enkhbold470/probelab/media/bottom.png

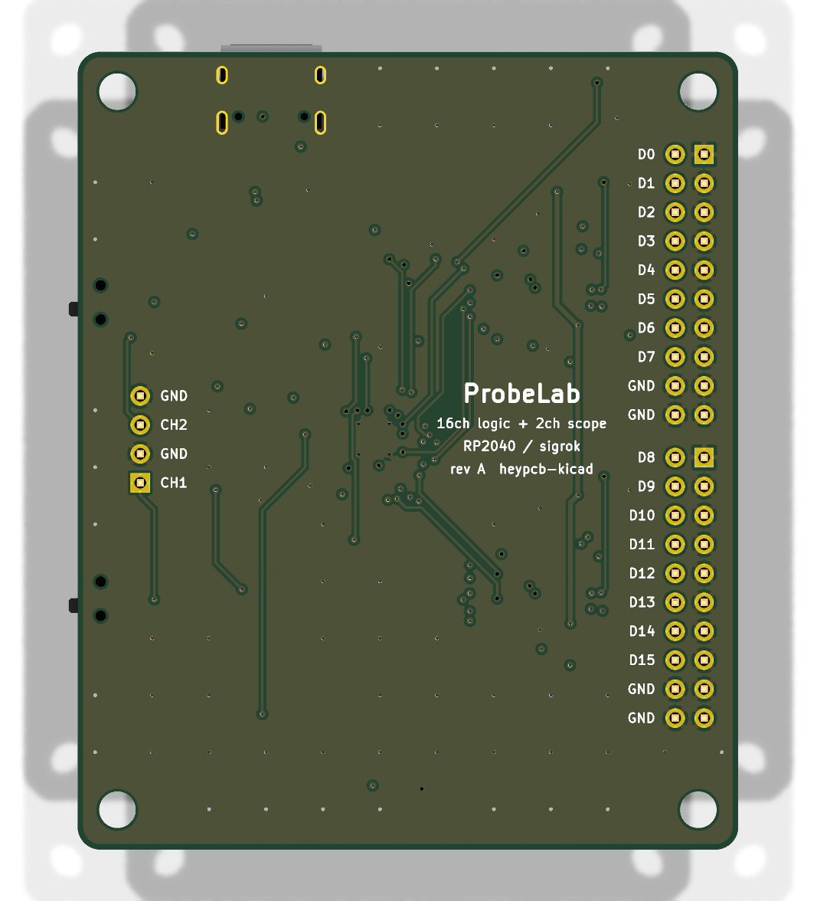
media/bottom.png
