enkhbold470/probelab/media/top.png

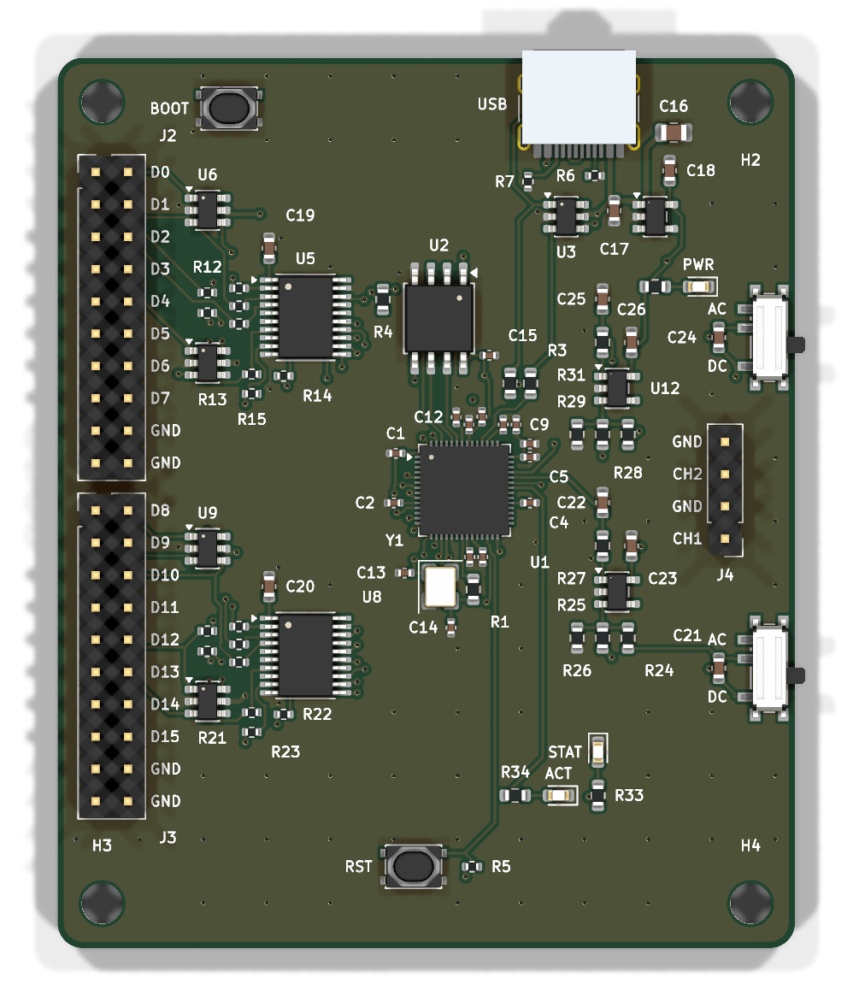
media/top.png
