enkhbold470/probelab/fab/probelab_bom.csv

Reference | Value | Footprint | MPN | LCSC | Qty
C1,C2,C3,C4,C5,C6,C7,C8,C11,C12,C15 | 100nF | Capacitor_SMD:C_0402_1005Metric | CL05B104KO5NNNC | C1525 | 11
C9,C10 | 1uF | Capacitor_SMD:C_0402_1005Metric | CL05A105KA5NQNC | C52923 | 2
C13,C14 | 15pF | Capacitor_SMD:C_0402_1005Metric | 0402CG150J500NT | C1548 | 2
C16 | 10uF | Capacitor_SMD:C_0805_2012Metric | CL21A106KAYNNNE | C15850 | 1
C17,C18 | 1uF | Capacitor_SMD:C_0603_1608Metric | CL10A105KB8NNNC | C15849 | 2
C19,C20,C21,C23,C24,C26 | 100nF | Capacitor_SMD:C_0603_1608Metric | CC0603KRX7R9BB104 | C14663 | 6
C22,C25 | 1nF | Capacitor_SMD:C_0603_1608Metric | CL10B102KB8NNNC | C1588 | 2
D1 | Green (PWR) | LED_SMD:LED_0603_1608Metric | KT-0603G | C12624 | 1
D2 | Red (STAT) | LED_SMD:LED_0603_1608Metric | KT-0603R | C2286 | 1
D3 | Red (ACT) | LED_SMD:LED_0603_1608Metric | KT-0603R | C2286 | 1
J1 | USB-C | Connector_USB:USB_C_Receptacle_HRO_TYPE-C-31-M-12 | TYPE-C-31-M-12 | C165948 | 1
J2,J3 | Conn_02x10 | Connector_PinHeader_2.54mm:PinHeader_2x10_P2.54mm_Vertical | PZ254V-12-20P | C492427 | 2
J4 | SCOPE | Connector_PinHeader_2.54mm:PinHeader_1x04_P2.54mm_Vertical | PZ254V-11-04P | C2691448 | 1
R1,R4,R32,R33,R34 | 1k | Resistor_SMD:R_0603_1608Metric | 0603WAF1001T5E | C21190 | 5
R2,R3 | 27R | Resistor_SMD:R_0603_1608Metric | 0603WAF270JT5E | C25190 | 2
R5 | 10k | Resistor_SMD:R_0402_1005Metric | 0402WGF1002TCE | C25744 | 1
R6,R7 | 5.1k | Resistor_SMD:R_0402_1005Metric | 0402WGF5101TCE | C25905 | 2
R8,R9,R10,R11,R12,R13,R14,R15,R16,R17,R18,R19,R20,R21,R22,R23 | 100R | Resistor_SMD:R_0402_1005Metric | 0402WGF1000TCE | C25076 | 16
R24,R28 | 1M | Resistor_SMD:R_0603_1608Metric | 0603WAF1004T5E | C22935 | 2
R25,R26,R29,R30 | 220k | Resistor_SMD:R_0603_1608Metric | 0603WAF2203T5E | C22961 | 4
R27,R31 | 47R | Resistor_SMD:R_0603_1608Metric | 0603WAF470JT5E | C23182 | 2
SW1,SW2 | PCM12SMTR | Button_Switch_SMD:SW_SPDT_PCM12 | PCM12SMTR | C221841 | 2
SW3 | BOOTSEL | Button_Switch_SMD:SW_SPST_PTS810 | PTS810SJM250SMTRLFS | C116501 | 1
SW4 | RESET | Button_Switch_SMD:SW_SPST_PTS810 | PTS810SJM250SMTRLFS | C116501 | 1
U1 | RP2040 | Package_DFN_QFN:QFN-56-1EP_7x7mm_P0.4mm_EP3.2x3.2mm_ThermalVias | RP2040 | C2040 | 1
U2 | W25Q128JVSIQ | Package_SO:SOIC-8_5.3x5.3mm_P1.27mm | W25Q128JVSIQ | C97521 | 1
U3 | USBLC6-2SC6 | Package_TO_SOT_SMD:SOT-23-6 | USBLC6-2SC6 | C7519 | 1
U4 | AP2112K-3.3 | Package_TO_SOT_SMD:SOT-23-5 | AP2112K-3.3TRG1 | C51118 | 1
U5,U8 | SN74LVC245APWR | Package_SO:TSSOP-20_4.4x6.5mm_P0.65mm | SN74LVC245APWR | C7848 | 2
U6,U7,U9,U10 | USBLC6-4SC6 | Package_TO_SOT_SMD:SOT-23-6 | USBLC6-4SC6 | C111212 | 4
U11,U12 | TLV9061IDBVR | Package_TO_SOT_SMD:SOT-23-5 | TLV9061IDBVR | C398358 | 2
Y1 | 12MHz | Crystal:Crystal_SMD_3225-4Pin_3.2x2.5mm | ABM8-272-T3 | C20625731 | 1
