enkhbold470/probelab/fab/probelab.step

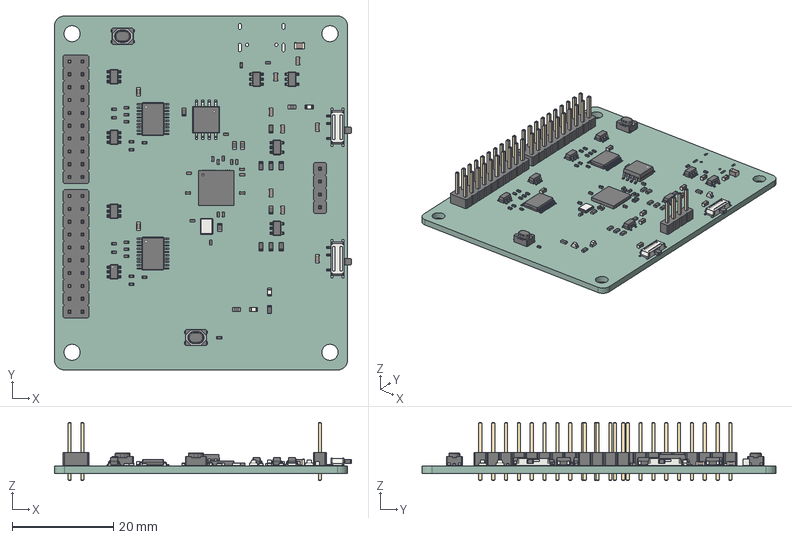
[picture p5: CAD file, 2026-10-02]
fab/probelab.step
58.8 x 70.0 x 11.5 mm
C_0402_1005Metric x 15
C_0603_1608Metric x 10
R_0402_1005Metric x 19
R_0603_1608Metric x 15
SOT-23-6 x 5
PinHeader_2x10_P254mm_Vertical x 2
PinHeader_1x04_P254mm_Vertical
SOT-23-5 x 3
SOIC-8_5.3x5.3mm_P1.27mm
Fusion_sp x 2
TSSOP-20_4.4x6.5mm_P0.65mm x 2
Crystal_SMD_3225-4Pin_3.2x2.5mm
QFN-56-1EP_7x7mm_P0.4mm_EP3.2x3.2mm
SW_SPST_PTS810 x 2
LED_0603_1608Metric x 3
C_0805_2012Metric
probelab_PCB
