enkhbold470/probelab/fab/probelab_schematic.pdf

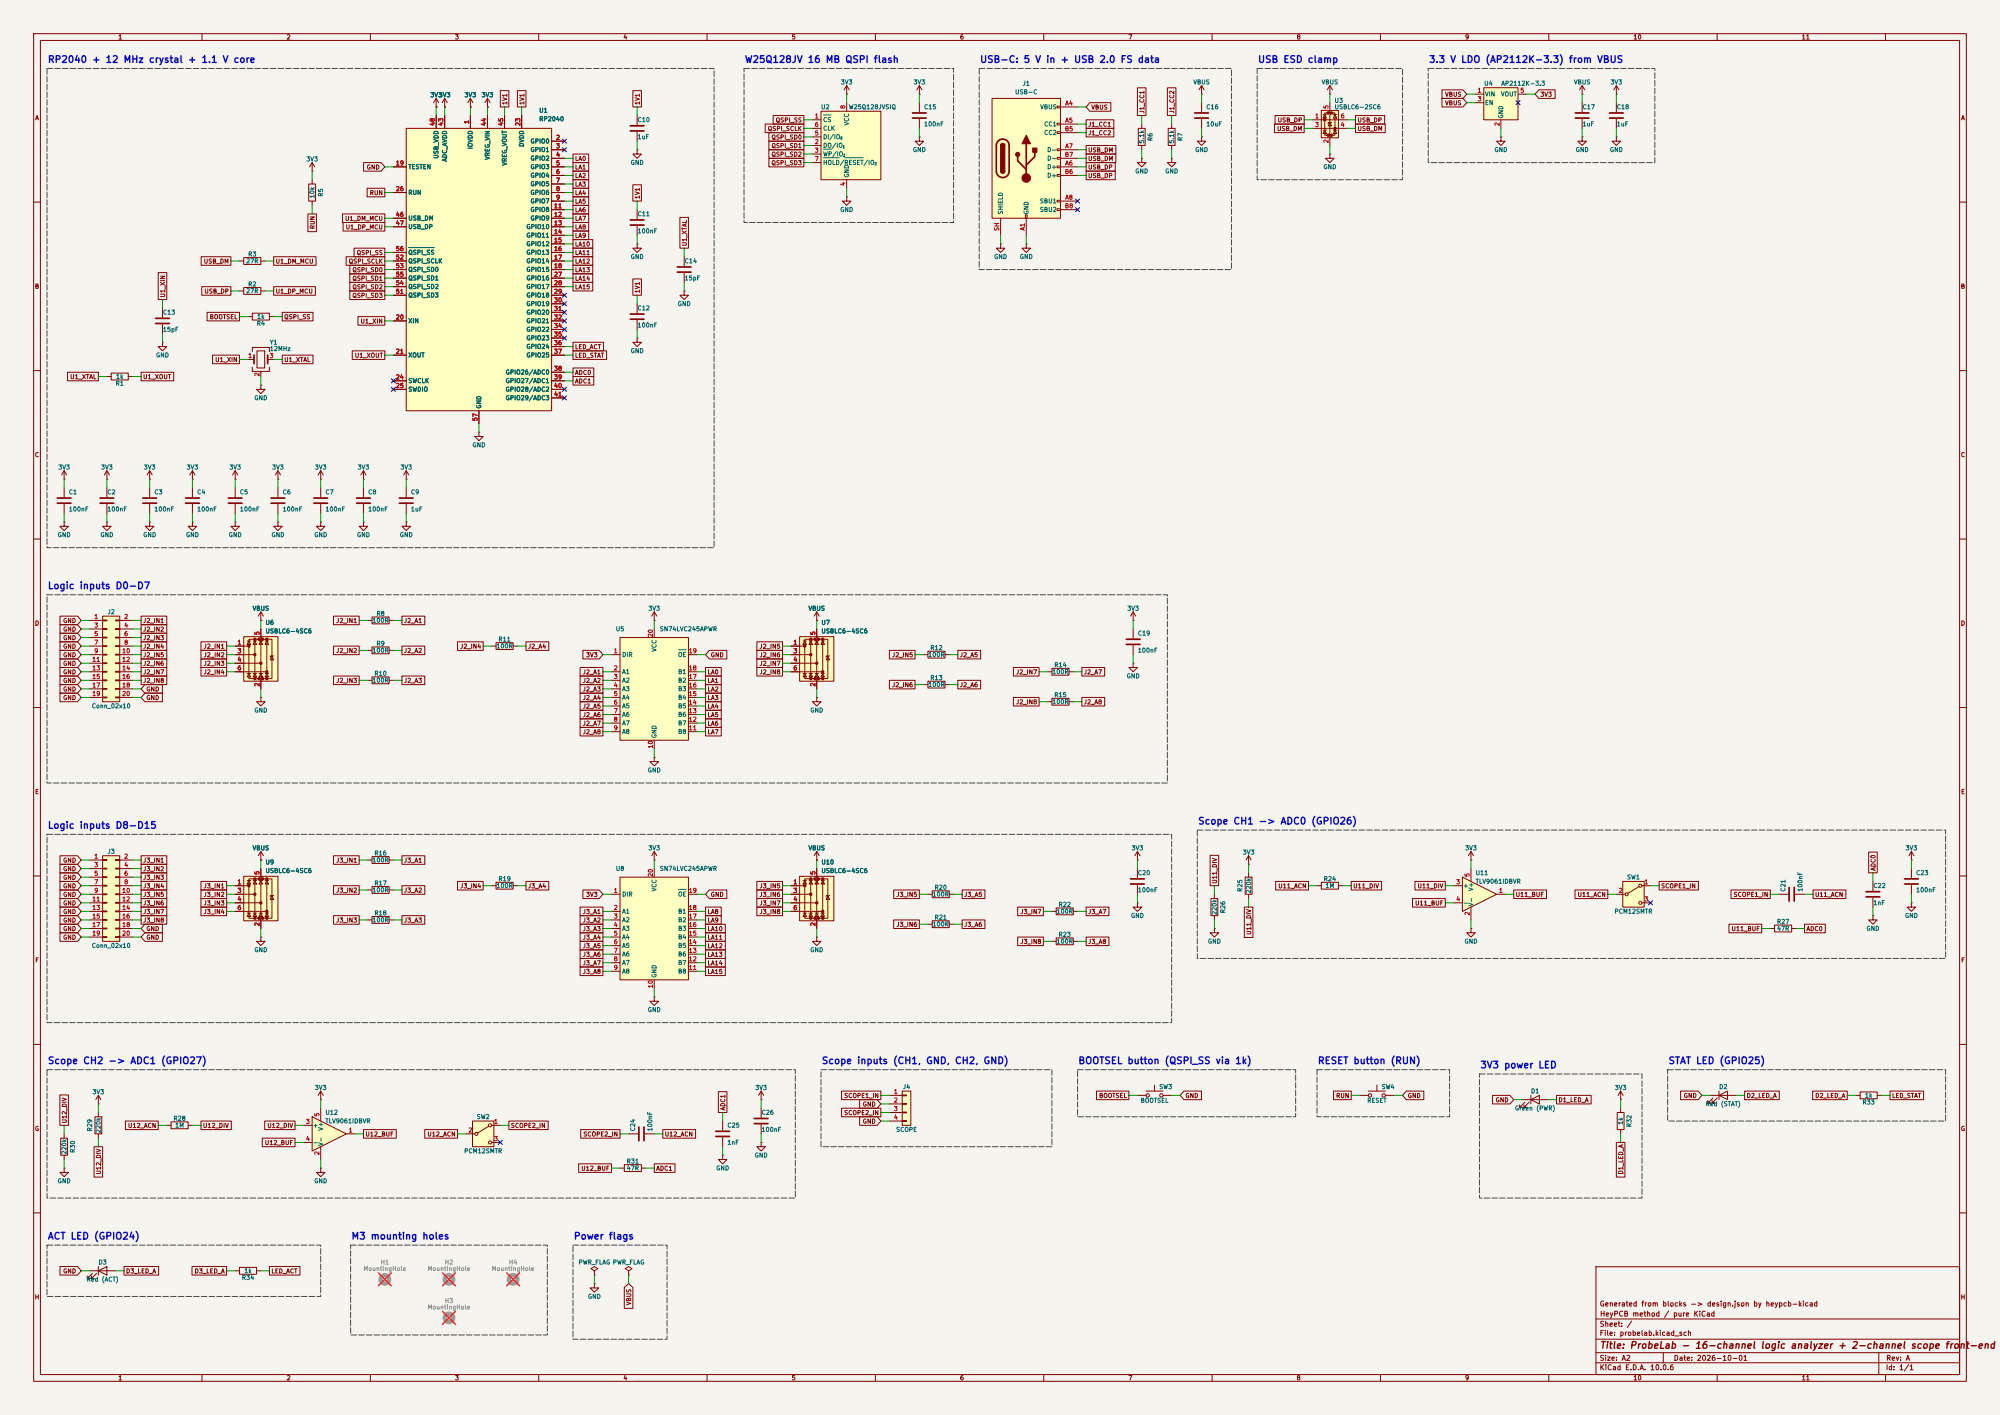
[picture p6: page 1]

4 DI/IO0 5 CLK 6 HOLD/RESET/IO3 7 VCC U2 8W25Q128JVSIQ

Scope inputs (CH1, GND, CH2, GND)

Generated from blocks -> design.json by heypcb-kicad
HeyPCB method / pure KiCad
Sheet: /
File: probelab.kicad_sch
Title: ProbeLab - 16-channel logic analyzer + 2-channel scope front-end (RP2040)

Size: A2 | Rev: A
KiCad E.D.A. 10.0.6 | Id: 1/1
