enkhbold470/probelab/kicad/probelab.kicad_pcb

## KiCad design kicad/probelab.kicad_pcb (2026-10-02)

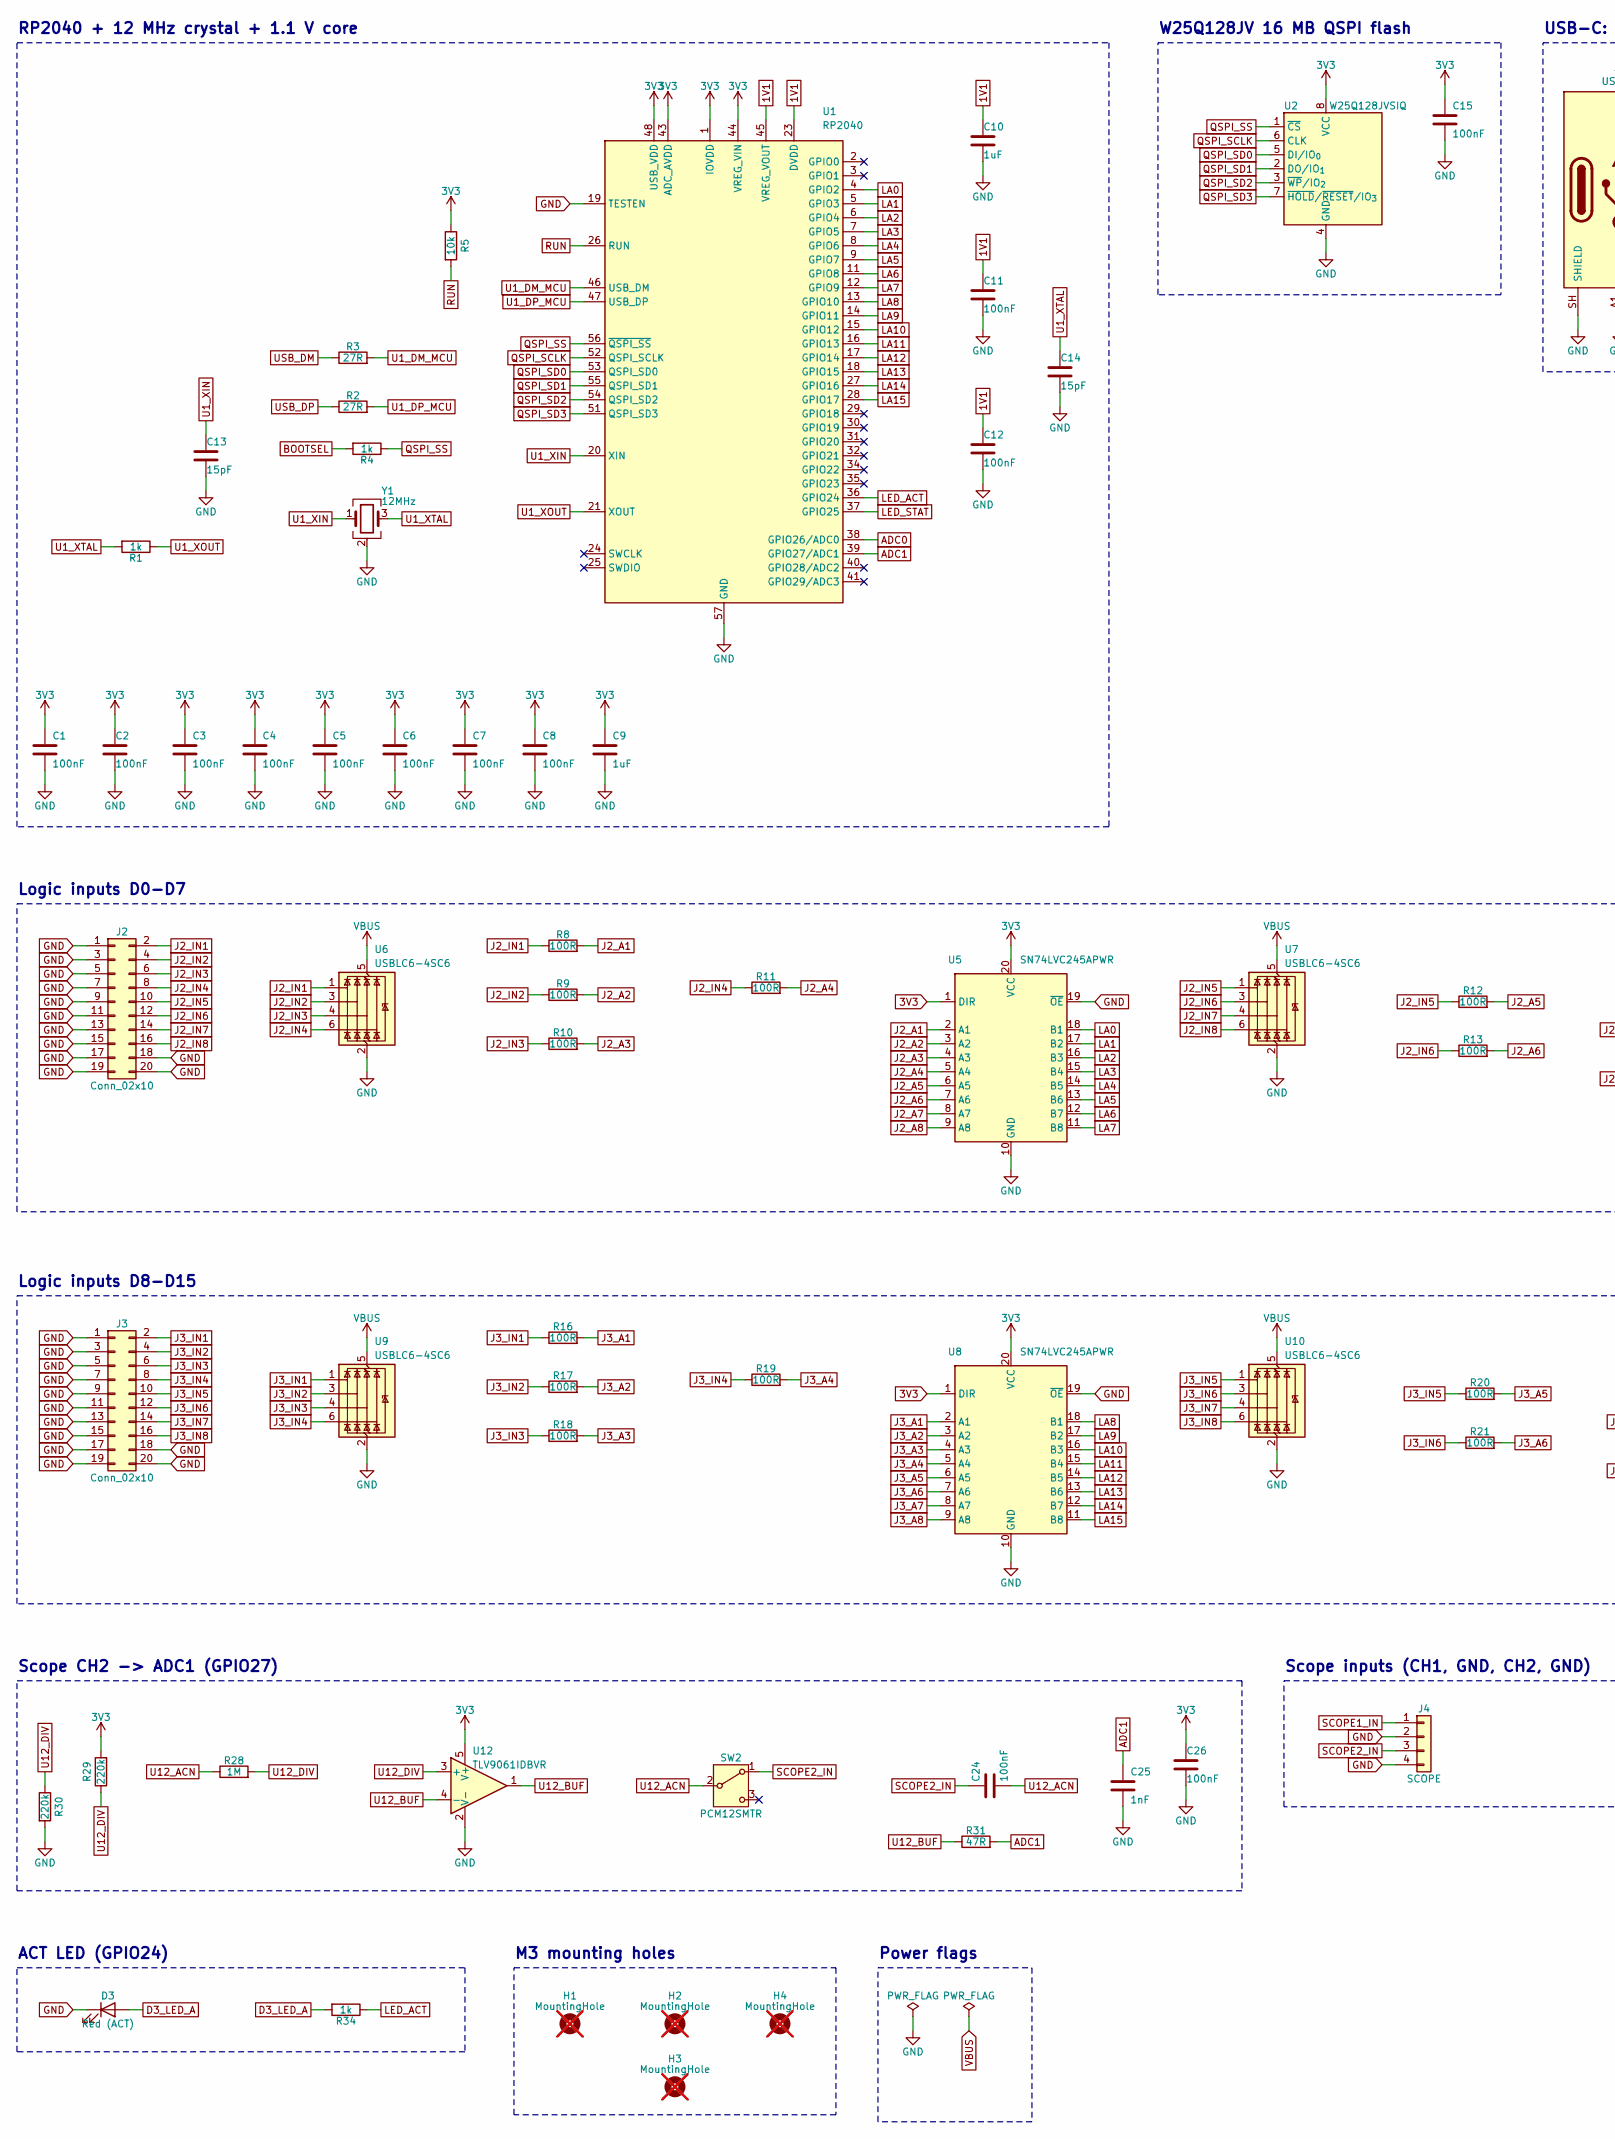
[picture p7: schematic probelab.kicad_sch, ProbeLab - 16-channel logic analyzer + 2-channel scope fron…, part in row 1, column 1]

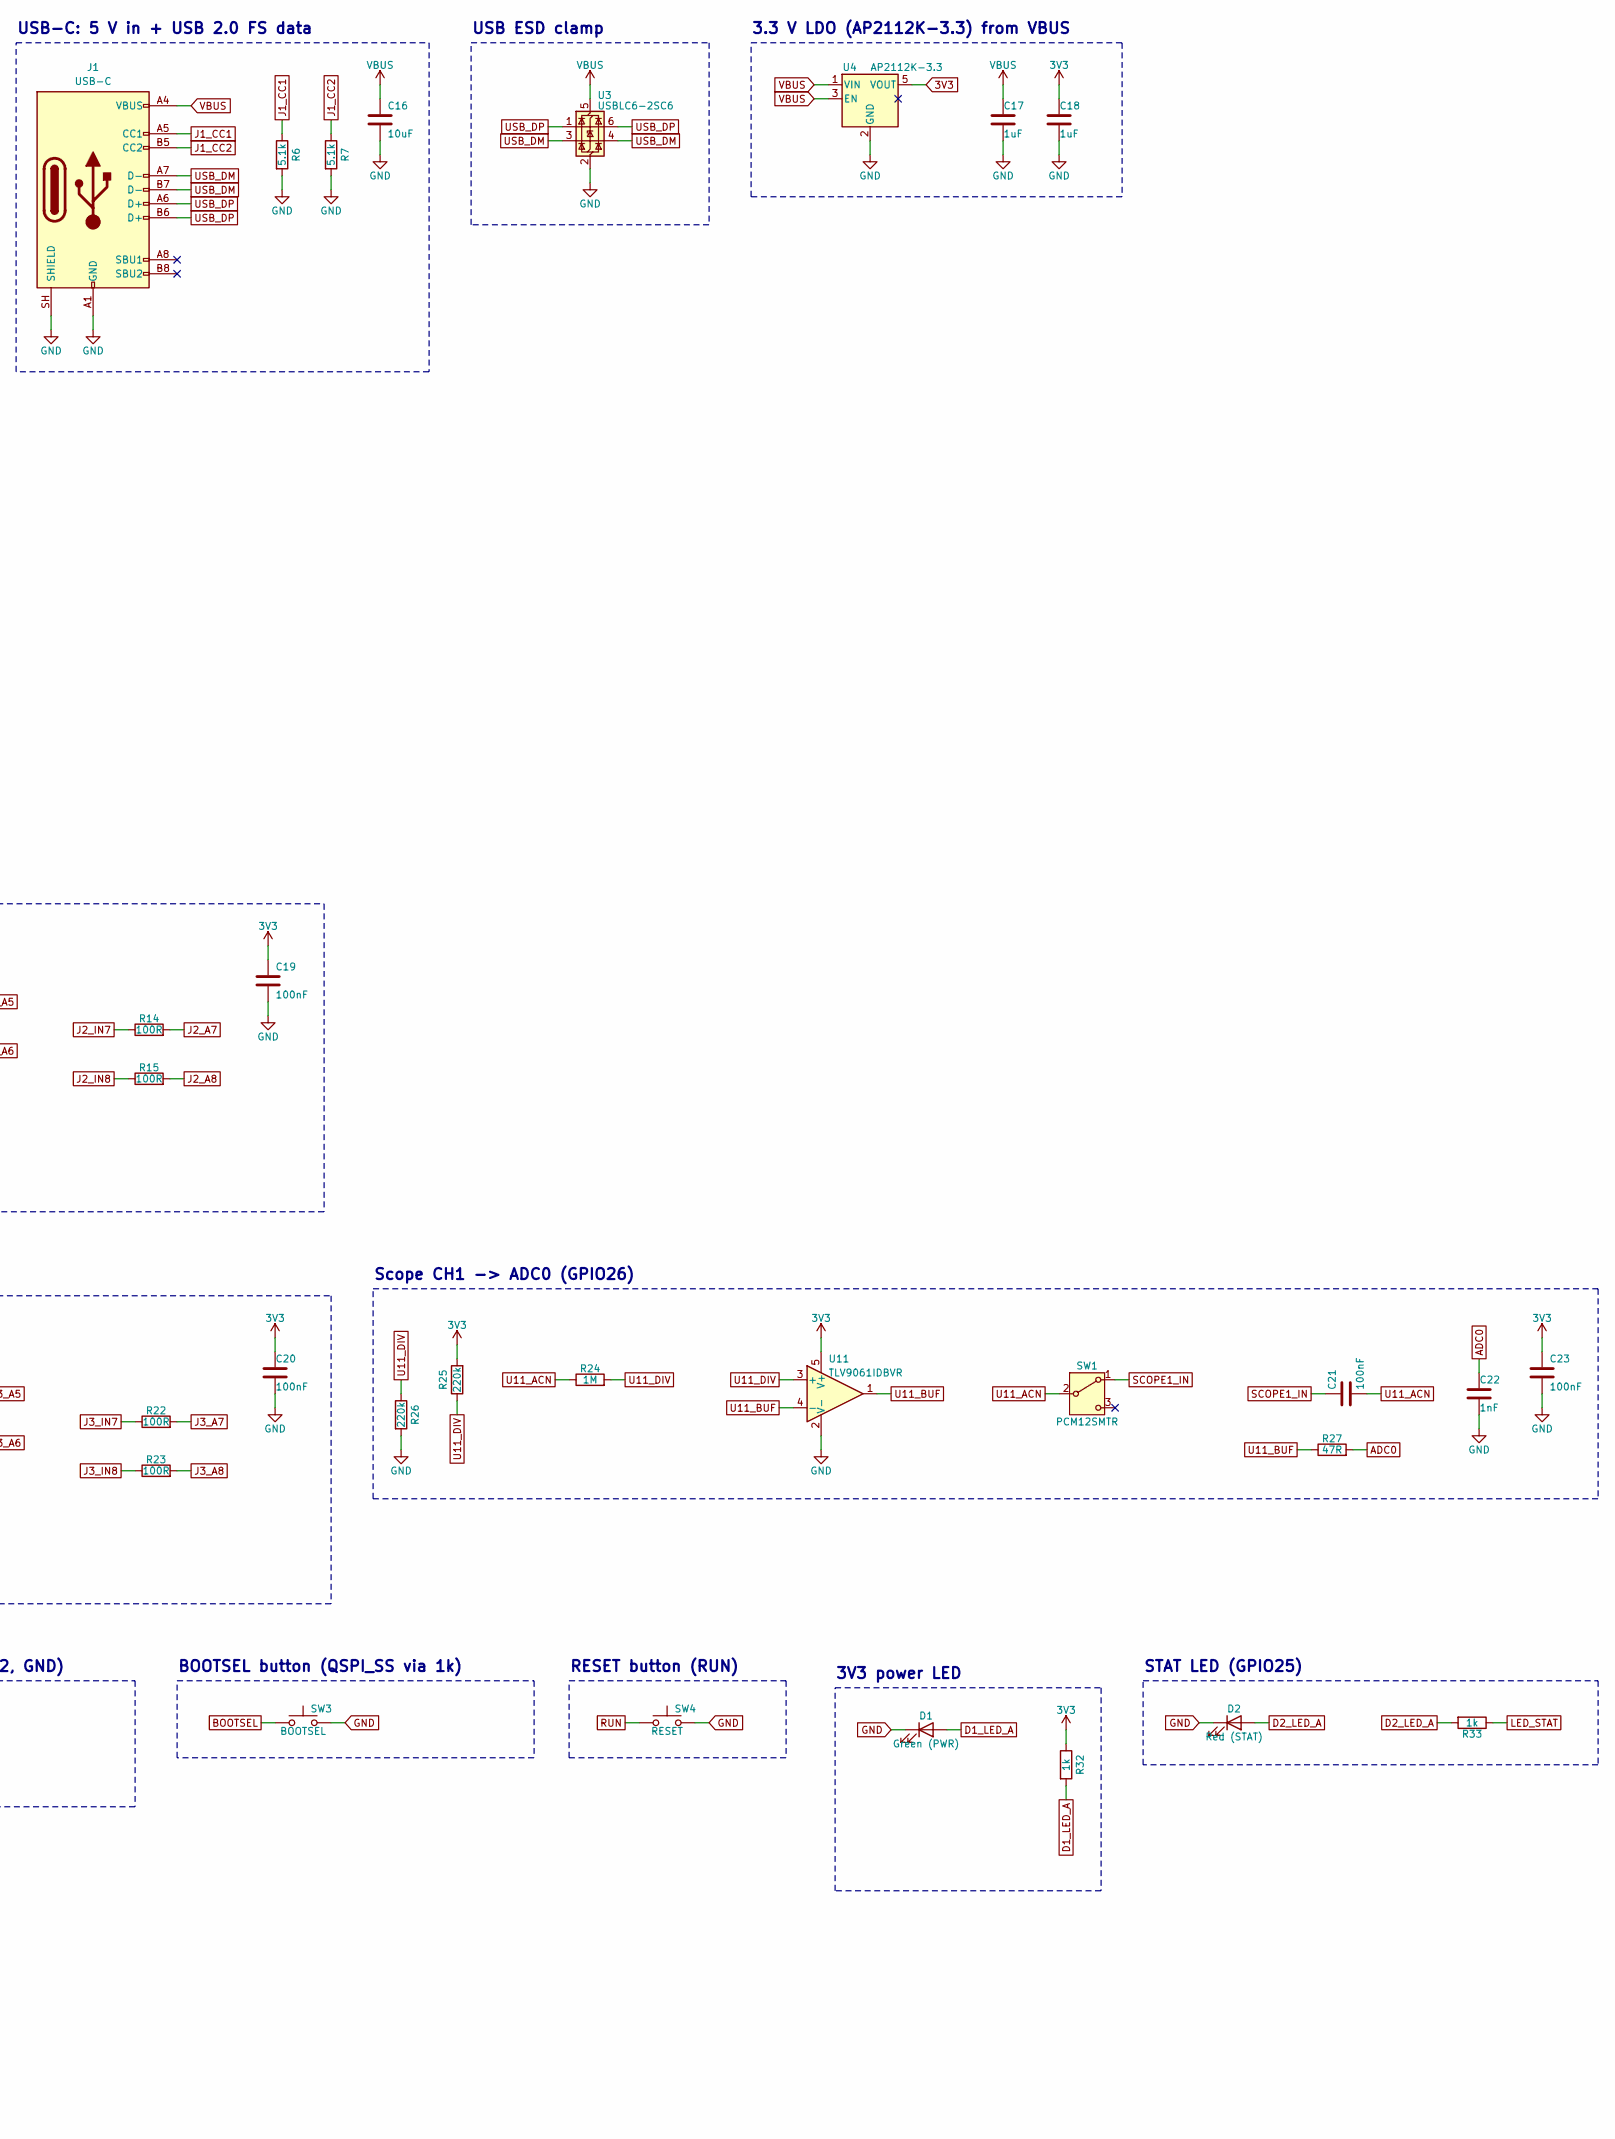
[picture p8: schematic probelab.kicad_sch, ProbeLab - 16-channel logic analyzer + 2-channel scope fron…, part in row 1, column 2]

Parts:
C1, C2, C3, C4, C5, C6, C7, C8, C11, C12, C15: 100nF; C_0402_1005Metric; MPN CL05B104KO5NNNC; LCSC C1525
C9, C10: 1uF; C_0402_1005Metric; MPN CL05A105KA5NQNC; LCSC C52923
C13, C14: 15pF; C_0402_1005Metric; MPN 0402CG150J500NT; LCSC C1548
C16: 10uF; C_0805_2012Metric; MPN CL21A106KAYNNNE; LCSC C15850
C17, C18: 1uF; C_0603_1608Metric; MPN CL10A105KB8NNNC; LCSC C15849
C19, C20, C21, C23, C24, C26: 100nF; C_0603_1608Metric; MPN CC0603KRX7R9BB104; LCSC C14663
C22, C25: 1nF; C_0603_1608Metric; MPN CL10B102KB8NNNC; LCSC C1588
D1: Green (PWR); LED_0603_1608Metric; MPN KT-0603G; LCSC C12624
D2: Red (STAT); LED_0603_1608Metric; MPN KT-0603R; LCSC C2286
D3: Red (ACT); LED_0603_1608Metric; MPN KT-0603R; LCSC C2286
H1, H2, H3, H4: MountingHole; MountingHole_3.2mm_M3; not fitted
J1: USB-C; USB_C_Receptacle_HRO_TYPE-C-31-M-12; MPN TYPE-C-31-M-12; LCSC C165948
J2, J3: Conn_02x10; PinHeader_2x10_P2.54mm_Vertical; MPN PZ254V-12-20P; LCSC C492427
J4: SCOPE; PinHeader_1x04_P2.54mm_Vertical; MPN PZ254V-11-04P; LCSC C2691448
R1, R4, R32, R33, R34: 1k; R_0603_1608Metric; MPN 0603WAF1001T5E; LCSC C21190
R2, R3: 27R; R_0603_1608Metric; MPN 0603WAF270JT5E; LCSC C25190
R5: 10k; R_0402_1005Metric; MPN 0402WGF1002TCE; LCSC C25744
R6, R7: 5.1k; R_0402_1005Metric; MPN 0402WGF5101TCE; LCSC C25905
R8, R9, R10, R11, R12, R13, R14, R15, R16, R17, R18, R19, R20, R21, R22, R23: 100R; R_0402_1005Metric; MPN 0402WGF1000TCE; LCSC C25076
R24, R28: 1M; R_0603_1608Metric; MPN 0603WAF1004T5E; LCSC C22935
R25, R26, R29, R30: 220k; R_0603_1608Metric; MPN 0603WAF2203T5E; LCSC C22961
R27, R31: 47R; R_0603_1608Metric; MPN 0603WAF470JT5E; LCSC C23182
SW1, SW2: PCM12SMTR; SW_SPDT_PCM12; MPN PCM12SMTR; LCSC C221841
SW3: BOOTSEL; SW_SPST_PTS810; MPN PTS810SJM250SMTRLFS; LCSC C116501
SW4: RESET; SW_SPST_PTS810; MPN PTS810SJM250SMTRLFS; LCSC C116501
U1: RP2040; QFN-56-1EP_7x7mm_P0.4mm_EP3.2x3.2mm_ThermalVias; MPN RP2040; LCSC C2040
U2: W25Q128JVSIQ; SOIC-8_5.3x5.3mm_P1.27mm; MPN W25Q128JVSIQ; LCSC C97521
U3: USBLC6-2SC6; SOT-23-6; MPN USBLC6-2SC6; LCSC C7519
U4: AP2112K-3.3; SOT-23-5; MPN AP2112K-3.3TRG1; LCSC C51118
U5, U8: SN74LVC245APWR; TSSOP-20_4.4x6.5mm_P0.65mm; MPN SN74LVC245APWR; LCSC C7848
U6, U7, U9, U10: USBLC6-4SC6; SOT-23-6; MPN USBLC6-4SC6; LCSC C111212
U11, U12: TLV9061IDBVR; SOT-23-5; MPN TLV9061IDBVR; LCSC C398358
Y1: 12MHz; Crystal_SMD_3225-4Pin_3.2x2.5mm; MPN ABM8-272-T3; LCSC C20625731

Connections:
1V1: C10.1, C11.1, C12.1, U1.23 (DVDD), U1.45 (VREG_VOUT), U1.50 (DVDD)
3V3: C1.1, C2.1, C3.1, C4.1, C5.1, C6.1, C7.1, C8.1, C9.1, C15.1, C18.1, C19.1, C20.1, C23.1, C26.1, R5.1, R25.2, R29.2, R32.1, U1.1 (IOVDD), U1.10 (IOVDD), U1.22 (IOVDD), U1.33 (IOVDD), U1.42 (IOVDD), U1.43 (ADC_AVDD), U1.44 (VREG_VIN), U1.48 (USB_VDD), U1.49 (IOVDD), U2.8 (VCC), U4.5 (VOUT), U5.1 (DIR), U5.20 (VCC), U8.1 (DIR), U8.20 (VCC), U11.5 (V+), U12.5 (V+)
ADC0: C22.1, R27.2, U1.38 (GPIO26/ADC0)
ADC1: C25.1, R31.2, U1.39 (GPIO27/ADC1)
BOOTSEL: R4.2, SW3.1
D1_LED_A: D1.2 (A), R32.2
D2_LED_A: D2.2 (A), R33.2
D3_LED_A: D3.2 (A), R34.2
GND: C1.2, C2.2, C3.2, C4.2, C5.2, C6.2, C7.2, C8.2, C9.2, C10.2, C11.2, C12.2, C13.2, C14.2, C15.2, C16.2, C17.2, C18.2, C19.2, C20.2, C22.2, C23.2, C25.2, C26.2, D1.1 (K), D2.1 (K), D3.1 (K), J1.A1 (GND), J1.A12 (GND), J1.B1 (GND), J1.B12 (GND), J1.SH (SHIELD), J2.1, J2.3, J2.5, J2.7, J2.9, J2.11, J2.13, J2.15, J2.17, J2.18, J2.19, J2.20, J3.1, J3.3, J3.5, J3.7, J3.9, J3.11, J3.13, J3.15, J3.17, J3.18, J3.19, J3.20, J4.2, J4.4, R6.2, R7.2, R26.2, R30.2, SW3.2, SW4.2, U1.19 (TESTEN), U1.57 (GND), U2.4 (GND), U3.2 (GND), U4.2 (GND), U5.10 (GND), U5.19 (~OE), U6.2 (GND), U7.2 (GND), U8.10 (GND), U8.19 (~OE), U9.2 (GND), U10.2 (GND), U11.2 (V-), U12.2 (V-), Y1.2 (G), Y1.4 (G)
J1_CC1: J1.A5 (CC1), R6.1
J1_CC2: J1.B5 (CC2), R7.1
J2_A1: R8.2, U5.2 (A1)
J2_A2: R9.2, U5.3 (A2)
J2_A3: R10.2, U5.4 (A3)
J2_A4: R11.2, U5.5 (A4)
J2_A5: R12.2, U5.6 (A5)
J2_A6: R13.2, U5.7 (A6)
J2_A7: R14.2, U5.8 (A7)
J2_A8: R15.2, U5.9 (A8)
J2_IN1: J2.2, R8.1, U6.1 (I/O1)
J2_IN2: J2.4, R9.1, U6.3 (I/O2)
J2_IN3: J2.6, R10.1, U6.4 (I/O3)
J2_IN4: J2.8, R11.1, U6.6 (I/O4)
J2_IN5: J2.10, R12.1, U7.1 (I/O1)
J2_IN6: J2.12, R13.1, U7.3 (I/O2)
J2_IN7: J2.14, R14.1, U7.4 (I/O3)
J2_IN8: J2.16, R15.1, U7.6 (I/O4)
J3_A1: R16.2, U8.2 (A1)
J3_A2: R17.2, U8.3 (A2)
J3_A3: R18.2, U8.4 (A3)
J3_A4: R19.2, U8.5 (A4)
J3_A5: R20.2, U8.6 (A5)
J3_A6: R21.2, U8.7 (A6)
J3_A7: R22.2, U8.8 (A7)
J3_A8: R23.2, U8.9 (A8)
J3_IN1: J3.2, R16.1, U9.1 (I/O1)
J3_IN2: J3.4, R17.1, U9.3 (I/O2)
J3_IN3: J3.6, R18.1, U9.4 (I/O3)
J3_IN4: J3.8, R19.1, U9.6 (I/O4)
J3_IN5: J3.10, R20.1, U10.1 (I/O1)
J3_IN6: J3.12, R21.1, U10.3 (I/O2)
J3_IN7: J3.14, R22.1, U10.4 (I/O3)
J3_IN8: J3.16, R23.1, U10.6 (I/O4)
LA0: U1.4 (GPIO2), U5.18 (B1)
LA1: U1.5 (GPIO3), U5.17 (B2)
LA2: U1.6 (GPIO4), U5.16 (B3)
LA3: U1.7 (GPIO5), U5.15 (B4)
LA4: U1.8 (GPIO6), U5.14 (B5)
LA5: U1.9 (GPIO7), U5.13 (B6)
LA6: U1.11 (GPIO8), U5.12 (B7)
LA7: U1.12 (GPIO9), U5.11 (B8)
LA8: U1.13 (GPIO10), U8.18 (B1)
LA9: U1.14 (GPIO11), U8.17 (B2)
LA10: U1.15 (GPIO12), U8.16 (B3)
LA11: U1.16 (GPIO13), U8.15 (B4)
LA12: U1.17 (GPIO14), U8.14 (B5)
LA13: U1.18 (GPIO15), U8.13 (B6)
LA14: U1.27 (GPIO16), U8.12 (B7)
LA15: U1.28 (GPIO17), U8.11 (B8)
LED_ACT: R34.1, U1.36 (GPIO24)
LED_STAT: R33.1, U1.37 (GPIO25)
QSPI_SCLK: U1.52 (QSPI_SCLK), U2.6 (CLK)
QSPI_SD0: U1.53 (QSPI_SD0), U2.5 (DI/IO_{0})
QSPI_SD1: U1.55 (QSPI_SD1), U2.2 (DO/IO_{1})
QSPI_SD2: U1.54 (QSPI_SD2), U2.3 (~WP/IO_{2})
QSPI_SD3: U1.51 (QSPI_SD3), U2.7 (~HOLD/~RESET/IO_{3})
QSPI_SS: R4.1, U1.56 (~QSPI_SS), U2.1 (~CS)
RUN: R5.2, SW4.1, U1.26 (RUN)
SCOPE1_IN: C21.1, J4.1, SW1.1 (A)
SCOPE2_IN: C24.1, J4.3, SW2.1 (A)
U1_DM_MCU: R3.2, U1.46 (USB_DM)
U1_DP_MCU: R2.2, U1.47 (USB_DP)
U1_XIN: C13.1, U1.20 (XIN), Y1.1
U1_XOUT: R1.1, U1.21 (XOUT)
U1_XTAL: C14.1, R1.2, Y1.3
U11_ACN: C21.2, R24.1, SW1.2 (B)
U11_BUF: R27.1, U11.1, U11.4 (-)
U11_DIV: R24.2, R25.1, R26.1, U11.3 (+)
U12_ACN: C24.2, R28.1, SW2.2 (B)
U12_BUF: R31.1, U12.1, U12.4 (-)
U12_DIV: R28.2, R29.1, R30.1, U12.3 (+)
USB_DM: J1.A7 (D-), J1.B7 (D-), R3.1, U3.3 (I/O2), U3.4 (I/O2)
USB_DP: J1.A6 (D+), J1.B6 (D+), R2.1, U3.1 (I/O1), U3.6 (I/O1)
VBUS: C16.1, C17.1, J1.A4 (VBUS), J1.A9 (VBUS), J1.B4 (VBUS), J1.B9 (VBUS), U3.5 (VBUS), U4.1 (VIN), U4.3 (EN), U6.5 (VBUS), U7.5 (VBUS), U9.5 (VBUS), U10.5 (VBUS)

Notes on the sheet:
RP2040 + 12 MHz crystal + 1.1 V core
W25Q128JV 16 MB QSPI flash
USB-C: 5 V in + USB 2.0 FS data
USB ESD clamp
3.3 V LDO (AP2112K-3.3) from VBUS
Logic inputs D0-D7
Logic inputs D8-D15
Scope CH1 -> ADC0 (GPIO26)
Scope CH2 -> ADC1 (GPIO27)
Scope inputs (CH1, GND, CH2, GND)
BOOTSEL button (QSPI_SS via 1k)
RESET button (RUN)
3V3 power LED
STAT LED (GPIO25)
ACT LED (GPIO24)
M3 mounting holes
Power flags

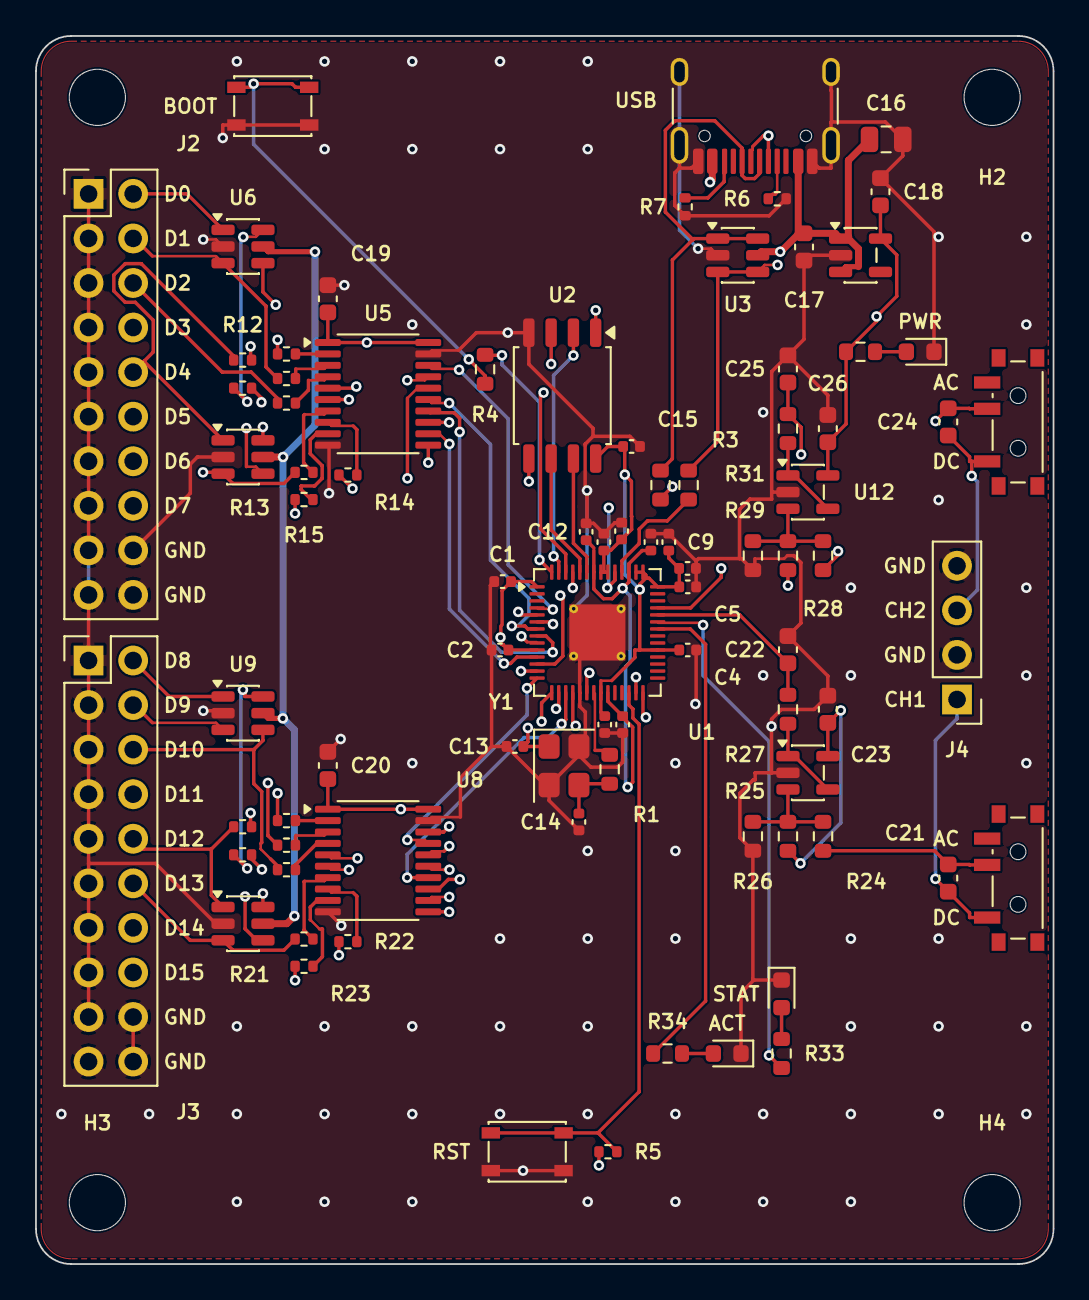
[picture p9: board probelab.kicad_pcb from above]

Board: 4 copper layers, 58.0 x 70.0 mm, 88 parts (0 on the bottom side), 84 nets.
